da-luce/ece4760_final_project/README.md

# ECE 4760 Final Project

Currently working in PWM_Demo.

## VGA + Motor Control

### PIO Conflicts

- VGA uses `pio0`
  - Three programs: `rgb.pio`, `hysync.pio`, and `vsync.pio`
- Control of a single motor requires three `pio` programs:
  - `pacer.pio`
  - `stepper.pio`
  - `counter.pio`

Since we only have two PIO blocks (`pio0` and `pio1`), with four state machines
for each, **all motor PIO programs must go on `pio1`**.

Thus, we have the current PIO setup:

| Block  | Function | Used state machines (out of 4) |
| --- | --- | --- |
| `pio0` | VGA | 3 |
| `pio1` | Stepper Motor | 3 |

### DMA Conflicts

- 12 total DMA channels on RP2040
- Stepper control is hard coded to use channels 0-9
- VGA claims two unused channels (10 and 11)

## Important Links

- [Course Webpage](https://ece4760.github.io/)
- [Lab Page](https://vanhunteradams.com/Pico/Helicopter/Helicopter.html)
- [Pico Pins](https://datasheets.raspberrypi.com/pico/pico-datasheet.pdf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)
- [VGA Pins](https://vanhunteradams.com/Pico/VGA/VGA.html#Attaching-hardware)
- [Debug Pins](https://www.raspberrypi.com/documentation/microcontrollers/debug-probe.html)
