da-luce/ece4760_final_project/input.jpg

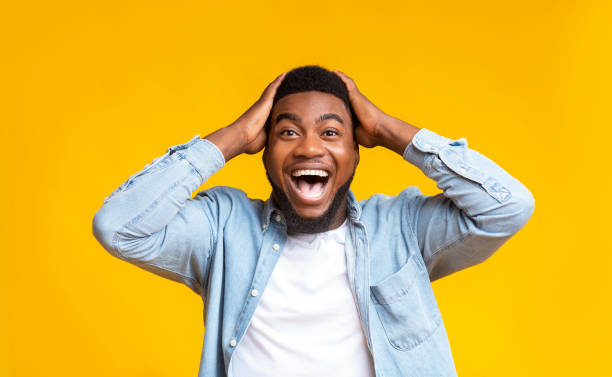
input.jpg
