da-luce/ece4760_final_project/webpage/spad.png

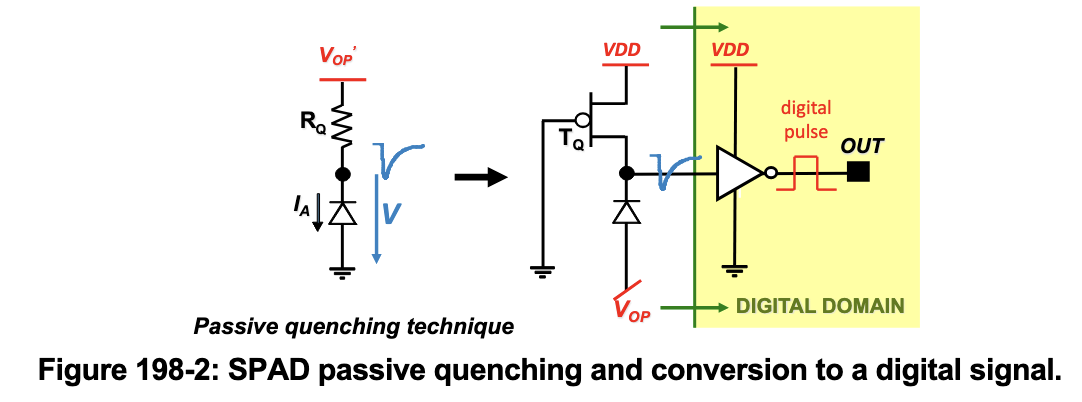
webpage/spad.png
