da-luce/ece4760_final_project/(commit log)

2025-04-09 add VGA files to PWM demo
2025-04-09 add text--but neet to ground to oscilloscope
2025-04-14 add reset button
2025-04-16 add basic UART
2025-04-16 read float from UART... maybe
2025-04-16 add uart test
2025-04-16 getting wrong stuff over uart
    [main.c]
2025-04-18 use fifo and dma
2025-04-21 Revert "use fifo and dma"
    This reverts commit 17485cfb1de36d1aaa9d49acb11808d8ede306d1.
    [main.c]
2025-04-23 working from sensor
2025-04-24 fix potential vga+button bug
    [main.c]
2025-04-25 debug button pressing
2025-04-25 add color heatmap
2025-04-30 add potential calibration
2025-04-30 try long distance, add smudge correction
    [uart_test.ino]
2025-05-07 scan line and gid fixes
    [main.c]
2025-05-12 add materials
2025-05-12 update button
2025-05-12 begin adding schematic
2025-05-12 update schematic
2025-05-12 add software schematic
2025-05-12 more updates to software schematic
2025-05-13 update tof sensor image
2025-05-16 update software schematic
2025-05-16 correct button logic
2025-05-16 move materials to appendix
2025-05-16 update intro, use LiDAR
2025-05-16 Arduino DUE -> Arduino Due
2025-05-17 Add uart cite
